HexabitzPlatform/H0FR7x-Hardware/README.md

# H0FR7x-Hardware
Hexabitz SPST 18V/20A MOSFET Switch Module Hardware Design
