HexabitzPlatform/H0FR7x-Hardware/Released/BOM/H0FR7.xlsx

 |  | www.hexabitz.com info@hexabitz.com |  | Bill Of Materials
Customer | Hexabitz | Revision | 3
Project | Hexabitz Modules | Date | 2024-06-17
Board | 20V/20A DC Switch / PWM Switch (H0FR7) | Notes
Designator | Description | Manufacturer Part Number | Manufacturer | Octopart Url | Quantity
X2 | 4 Position Wire to Board Terminal Block Horizontal with Board 0.200" (5.08mm) Through Hole | 1715747 | Phoenix Contact | https://octopart.com/1715747-phoenix+contact-35770?r=sp | 1
RESET | Headers & Wire Housings Unshrouded 1 POS T/H | 5-146280-1 | TE Connectivity | https://octopart.com/5-146280-1-te+connectivity+%2F+amp-40259676?r=sp | 1
SWD | Conn Unshrouded Header HDR 3 POS 2.54mm Solder ST Top Entry Thru-Hole Carton | 5-146281-3 | TE Connectivity | https://octopart.com/5-146281-3-te+connectivity+%2F+amp-39745942?r=sp | 1
R7 | Resistor Current Sense Metal Substrate 1206 2.5mOhm ±1% 1W ±50ppm/°C Paper T/R Automotive | PA1206FRE472U5Z | Yageo | https://octopart.com/pa1206fre472u5z-yageo-116359076?r=sp | 1
R2 | RES SMD 0.0OHM JUMPER 1/10W 0603 | RC0603JR-070RL | YAGEO [VR] | https://octopart.com/rc0603jr-070rl-yageo-1241539?r=sp | 1
R4 | RES 10 ohms 1/10w 1% 0603 | 0603WAF100JT5E | Royal Ohm | https://octopart.com/0603waf100jt5e-royal+ohm-127860301?r=sp | 1
R11 | SMD Chip Resistor, 47 Ohm, ± 1%, 100 mW, 0603 [1608 Metric], | RC0603FR-0747RL | Yageo | https://octopart.com/rc0603fr-0747rl-yageo-40952917?r=sp | 1
R5 | RES 150 OHM 1% 1/4W 0603 | CRGP0603F150R | TE Connectivity | https://octopart.com/1-2176326-5-te+connectivity-91016741?r=sp | 1
R1 | Thick Film Resistors - SMD 0603 270 Ohm 5% Tol | ERJ-3GEYJ271V | Panasonic | https://octopart.com/erj-3geyj271v-panasonic-55560546?r=sp | 1
R10, R13 | SMD Chip Resistor, 1 kOhm, ± 1%, 100 mW, 0603 [1608 Metric] | AC0603FR-131KL | Yageo | https://octopart.com/ac0603fr-131kl-yageo-73876229?r=sp | 2
R9 | 3.3 kOhms ±1% 0.1W, 1/10W Chip Resistor 0603 (1608 Metric) Moisture Resistant Thick Film | RC0603FR-073K3L | Yageo | https://octopart.com/rc0603fr-073k3l-yageo-40011875?r=sp | 1
R3 , R12 , R14 | RES 10K Ohm 1% 0603 | RC0603FR-0710KL | Yageo | https://octopart.com/rc0603fr-0710kl-yageo-40025538?r=sp | 3
R6, R8 | RES 49.9K OHM 1% 1/4W 0603 | ERJ-UP3F4992V | Panasonic Electronic Components | https://octopart.com/erj-up3f4992v-panasonic-108179032?r=sp | 2
R15 | RES 100K OHM 1% 1/10W 0603 | RC0603FR-10100KL | YAGEO | https://octopart.com/rc0603fr-10100kl-yageo-12819539?r=sp | 1
C14 | CAP 50V 1000pF 0603 X7R KEMET Multilayer Ceramic Capacitors MLCC-SMD/SMT | C0603C102J5RACTU | KEMET | https://octopart.com/c0603c102j5ractu-kemet-96704?r=sp | 1
C10, C11 | CAP CER 10000PF 50V X7R 0603 | CC0603KRX7R9BB103 | YAGEO | https://octopart.com/cc0603krx7r9bb103-yageo-192938?r=sp | 2
C1, C5, C7, C13 | CAP CER 0.1UF 25V X7R 0603 | CGA3E2X8R1E104K080AE | TDK | https://octopart.com/cga3e2x8r1e104k080ae-tdk-68305753?r=sp | 4
C8 ,C9 ,C12 | 0.1 µF ±10% 50V Ceramic Capacitor X7R 0603 (1608 Metric) | C1608X7R1H104K080AA | TDK | https://octopart.com/c1608x7r1h104k080aa-tdk-25947665?r=sp | 3
C2 | CAP CER 1 UF 16V X7R 0805 | CC0805KKX7R7BB105 | YAGEO [VA] | https://octopart.com/cc0805kkx7r7bb105-yageo-8376555?r=sp | 1
C6 | CAP CER 4.7UF 16V X7R 0805 | C0805C475K4RACTU | KEMET [VA] | https://octopart.com/c0805c475k4ractu-kemet-22859922?r=sp | 1
C15 | Aluminium Electrolytic Capacitors - Radial Leaded 35V 470uF 105C 2k Hour Radial | ESH477M035AH3AA | KEMET | https://octopart.com/esh477m035ah3aa-kemet-22264614?r=sp | 1
FB1 | Ind chip Bead Multi-Layer 30 ohms 25% 100MHZ Ferrite 1,5A 0603Punched paper T/R | MMZ1608Y300BTA00 | TDK | https://octopart.com/mmz1608y300bta00-tdk-7906990?r=sp | 1
D1 | Red 0603 130° Clear 54 mcd 2 V Surface Mount ChipLED | VLMS1300-GS08 | Vishay | https://octopart.com/vlms1300-gs08-vishay-21709201?r=sp&s=0nXJNjGsSbWwqfqWlZv0EA | 1
D2 | TVS DIODE 3,3V 10,9V SOD323 | CDSOD323-T03SC | BOURNS INC | https://octopart.com/cdsod323-t03sc-bourns-10487153?r=sp | 1
D3 ,D4 | Small Signal Diode, Single, 100 V, 300 Ma, 1.25 V, 4 Ns, 2 A Rohs | 1N4148W-7-F | Diodes Inc | https://octopart.com/1n4148w-7-f-diodes+inc.-55386411?r=sp | 2
D5 | Zener Diode 1.8 V 500 mW ±5% Surface Mount SOD-123 | MMSZ4678T1G | onsemi | https://octopart.com/mmsz4678t1g-onsemi-29993?r=sp | 1
D6 | Rectifier Diode, Schottky, 1 Phase, 1 Element, 2.8A, 100V | V8PAM10S-M3/H | Vishay | https://octopart.com/v8pam10s-m3%2Fh-vishay-109273831?r=sp | 1
Q2 | P-channel 40 V, 0.0175 Ω typ.,36 A, STripFET™ F6 Power MOSFET in a DPAK package | STD36P4LLF6 | STMicroelectronics | https://octopart.com/std36p4llf6-stmicroelectronics-34425371?r=sp | 1
Q1 | Transistor, Bipolar, Si, NPN, General Purpose, VCEO 40VDC, IC 200mA, PD 225mW, SOT-23 | MMBT3904LT1G | ON Semiconductor | https://octopart.com/mmbt3904lt1g-on+semiconductor-3280?r=sp | 1
U1 | MCU 32-bit ARM Cortex M0+ RISC 512KB Flash 1.8V/2.5V/3.3V 48-Pin UFQFPN EP Tray | STM32G0B1CEU6 | STMicroelectronics | https://octopart.com/stm32g0b1ceu6-stmicroelectronics-116363364?r=sp | 1
U2 | High bandwidth (20MH / Operational Amplifiers - Op Amps | TSV772IYDT | STMicroelectronics | https://octopart.com/tsv772iydt-stmicroelectronics-126487015?r=sp | 1
U3 | 40 V 1 A NPN/PNP Transistor Pair PushPull MOSFET Driver | PMD3001D,115 | Nexperia | https://octopart.com/pmd3001d%2C115-nexperia-78741352?r=sp | 1
X1 | 8,0000MHZ 33pF SMD MURATA Resonators | CSTNE8M00G550000R0 | Murata | https://octopart.com/cstne8m00g550000r0-murata-91406934?r=sp | 1
