HexabitzPlatform/H0FR7x-Hardware/Documentation/H0FR7 Schematics.pdf

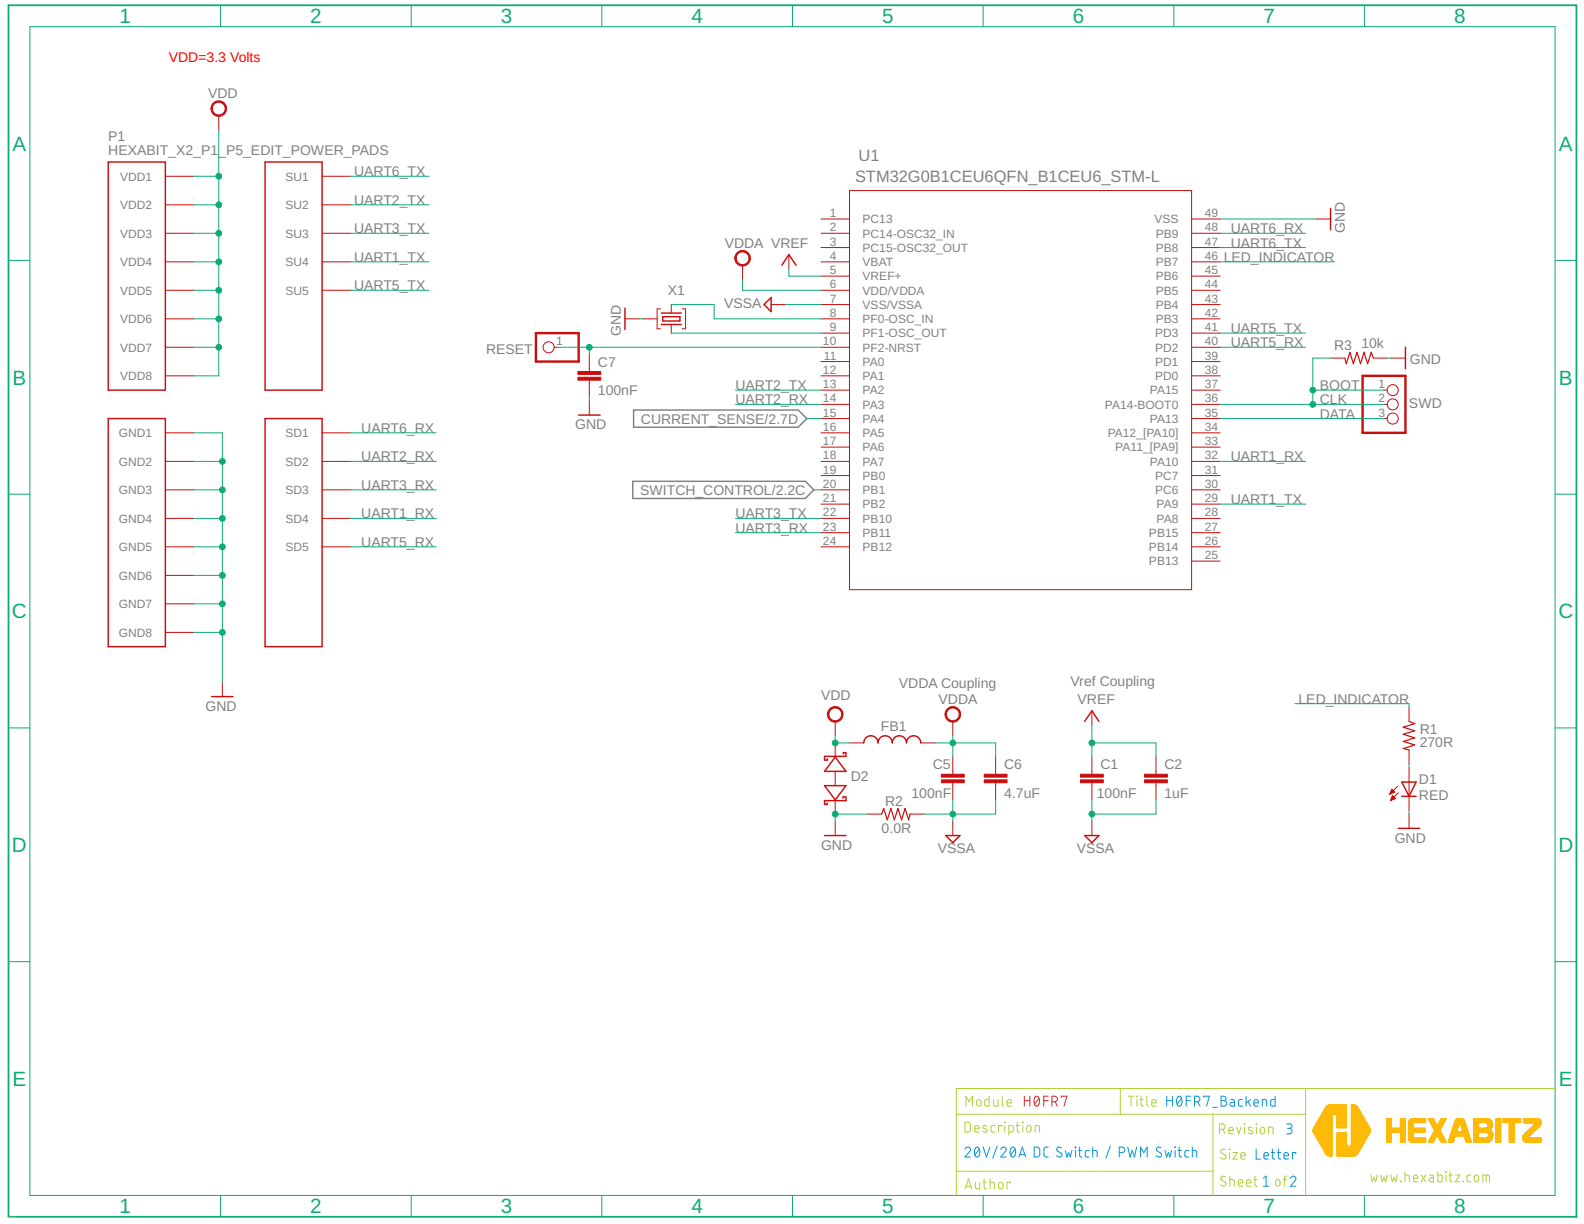
[picture p1: page 1]

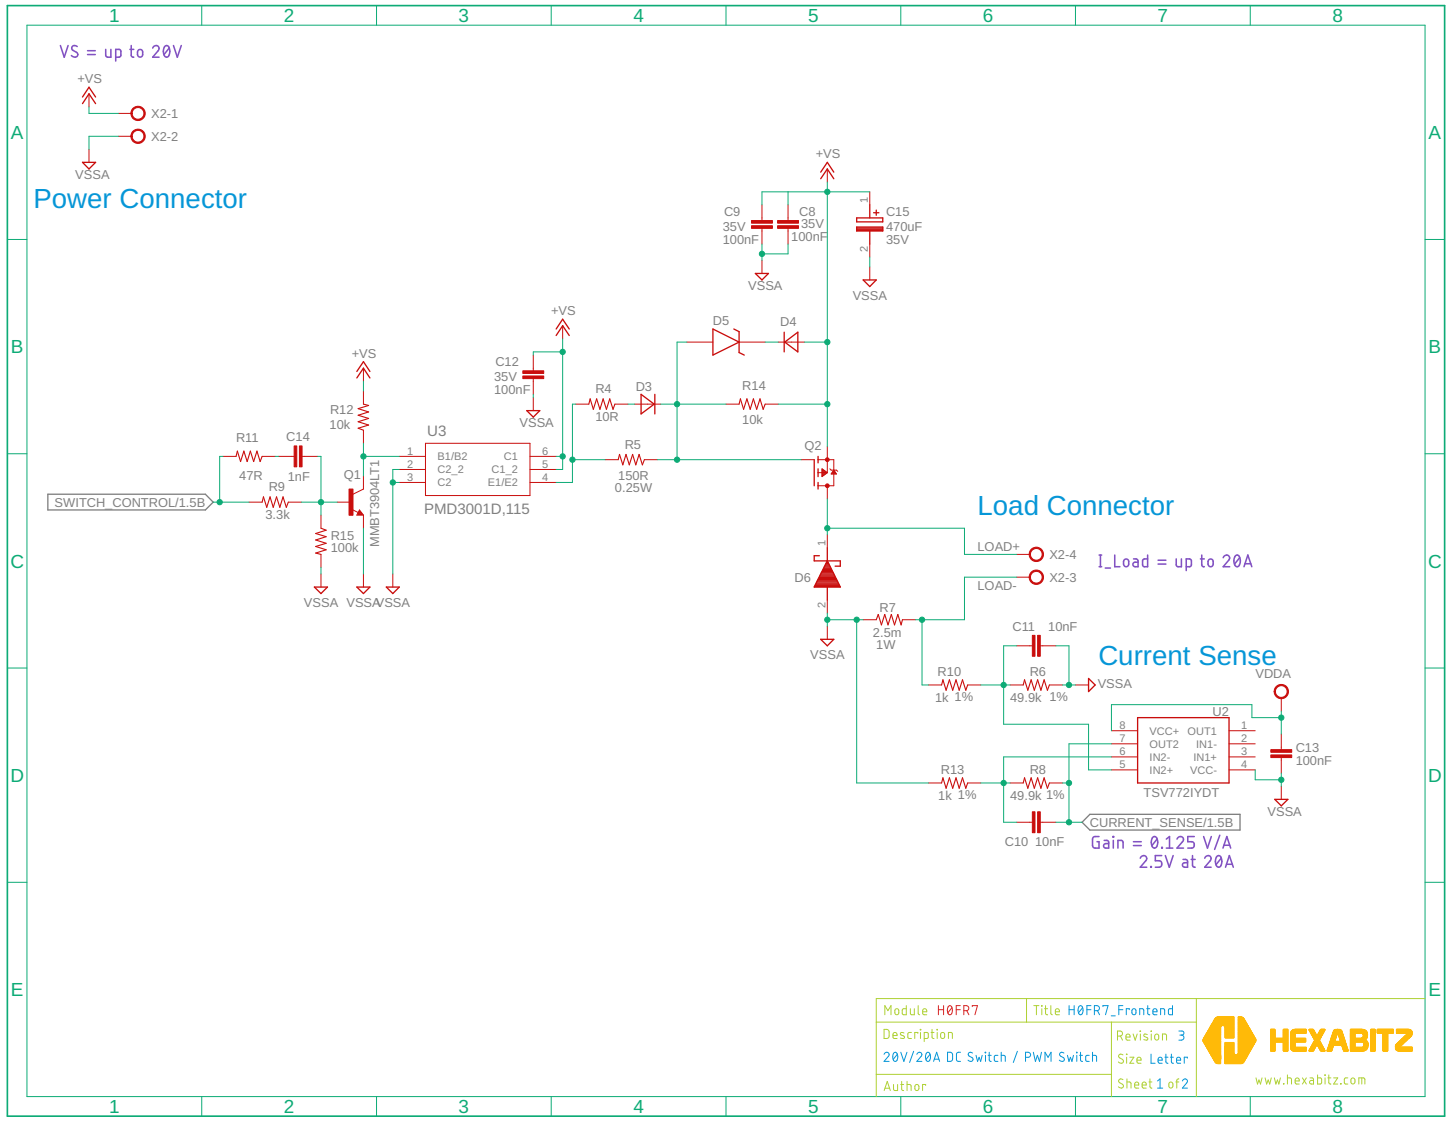
[picture p2: page 2]
