HexabitzPlatform/H0FR7x-Hardware/Design/H0FR7.brd

## EAGLE design Design/H0FR7.brd (2024-07-15)

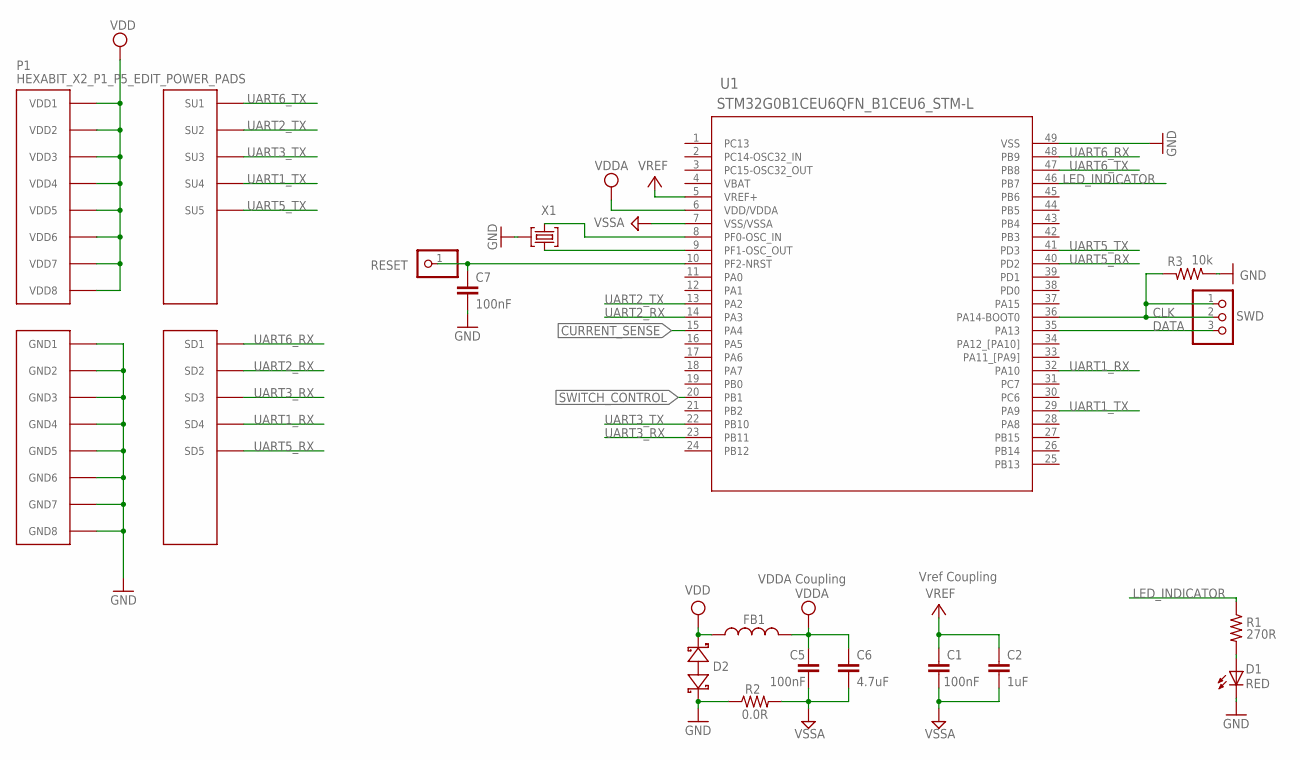
[picture p3: schematic H0FR7.sch, sheet 1]

Parts:
C1, C7: 100nF; C-0603; TOLERANCE 10%; VOLTAGE_RATING 10V; MPN C0603C104K8RACTU
C2: 1uF; C-0805
C5: 100nF; C-0603
C6: 4.7uF; C-0805
D1: RED; VLMS1300-GS08; MPN VLMS1300-GS08
D2: BOURNS_CDSOD323-T03SCBOURNS_CDSOD323-T03SC_0_0; BOURNS_CDSOD323-T03SC_0
FB1: FB-0603
P1: HEXABIT_X2_P1_P5_EDIT_POWER_PADS
R1: 270R; R-0603
R2: 0.0R; R-0603
R3: 10k; R-0603; TOLERANCE 5%; MPN RC0603JR-0710KL
RESET: R; 1X01
SWD: PINHD-1X3SWD; SWD
TRIMBLE-LOGO2: HEXA-LOGO
U1: STM32G0B1CEU6QFN_B1CEU6_STM-L; QFN_B1CEU6_STM-L
X1: XTALL_CSTCE8M00G52

Connections:
CLK: R3.2, SWD.1, SWD.2, U1.36 (PA14-BOOT0)
CURRENT_SENSE: U1.15 (PA4); also elsewhere on the board
DATA: SWD.3, U1.35 (PA13)
GND: C7.2, D1.C, D2.2 (C), P1.PAD_PD11 (GND1), P1.PAD_PD12 (GND2), P1.PAD_PD13 (GND3), P1.PAD_PD14 (GND4), P1.PAD_PD17 (GND5), P1.PAD_PD18 (GND6), P1.PAD_PD19 (GND7), P1.PAD_PD20 (GND8), R2.1, R3.1, U1.49 (VSS), X1.P$2 (2)
LED_INDICATOR: R1.1, U1.46 (PB7)
unnamed: U1.9 (PF1-OSC_OUT), X1.P$3 (3)
unnamed: U1.8 (PF0-OSC_IN), X1.P$1 (1)
unnamed: D1.A, R1.2
unnamed: C7.1, RESET.1, U1.10 (PF2-NRST)
SWITCH_CONTROL: U1.20 (PB1); also elsewhere on the board
UART1_RX: P1.PAD_PD4 (SD4), U1.32 (PA10)
UART1_TX: P1.PAD_PU4 (SU4), U1.29 (PA9)
UART2_RX: P1.PAD_PD2 (SD2), U1.14 (PA3)
UART2_TX: P1.PAD_PU2 (SU2), U1.13 (PA2)
UART3_RX: P1.PAD_PD3 (SD3), U1.23 (PB11)
UART3_TX: P1.PAD_PU3 (SU3), U1.22 (PB10)
UART5_RX: P1.PAD_PD5 (SD5), U1.40 (PD2)
UART5_TX: P1.PAD_PU5 (SU5), U1.41 (PD3)
UART6_RX: P1.PAD_PD1 (SD1), U1.48 (PB9)
UART6_TX: P1.PAD_PU1 (SU1), U1.47 (PB8)
VDD: D2.1 (A), FB1.1, P1.PAD_PU11 (VDD1), P1.PAD_PU12 (VDD2), P1.PAD_PU13 (VDD3), P1.PAD_PU14 (VDD4), P1.PAD_PU17 (VDD5), P1.PAD_PU18 (VDD6), P1.PAD_PU19 (VDD7), P1.PAD_PU20 (VDD8)
VDDA: C5.1, C6.1, FB1.2, U1.6 (VDD/VDDA); also elsewhere on the board
VREF: C1.1, C2.1, U1.5 (VREF+)
VSSA: C1.2, C2.2, C5.2, C6.2, R2.2, U1.7 (VSS/VSSA); also elsewhere on the board

Notes on the sheet:
Vref Coupling
VDDA Coupling

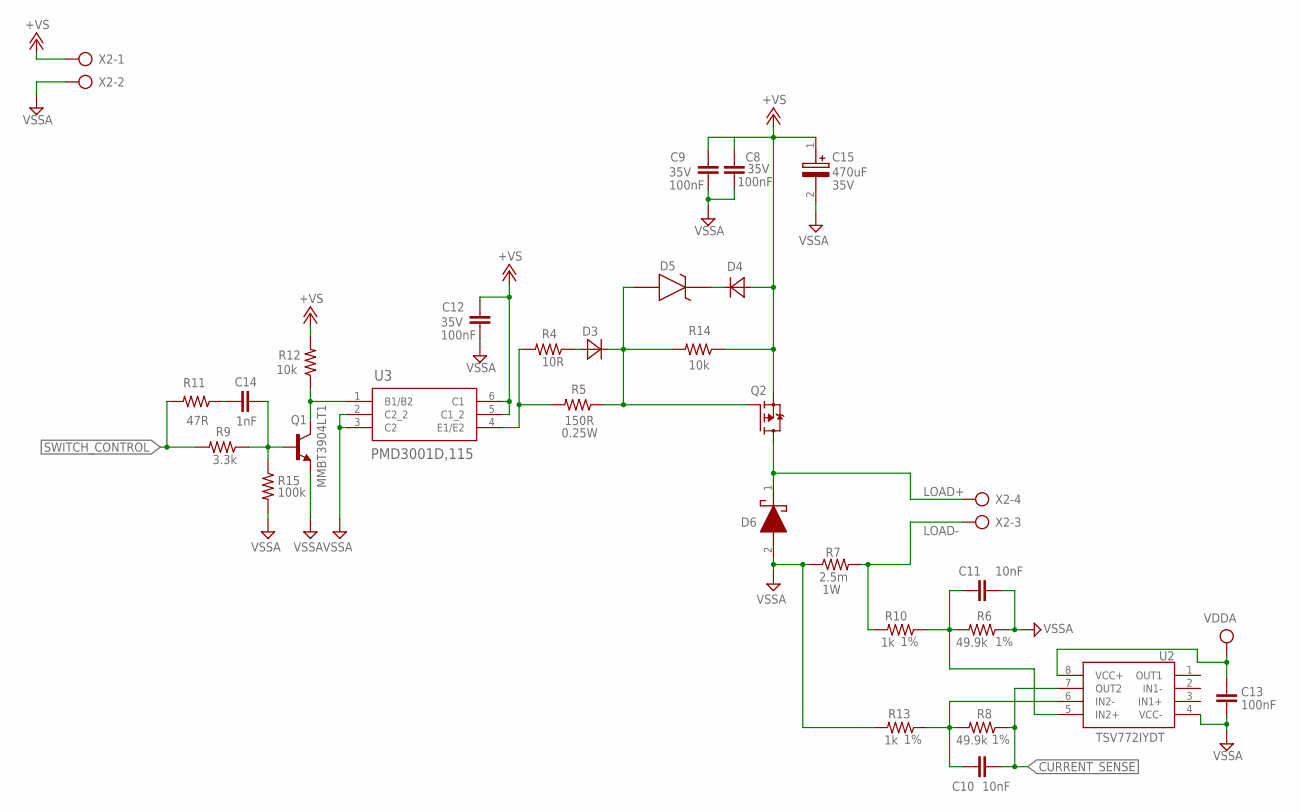
[picture p4: schematic H0FR7.sch, sheet 2]

Parts:
C8, C9, C12: C-0603; VOLTAGE_RATING 35V
C10, C11: 10nF; C-0603; TOLERANCE 10V; VOLTAGE_RATING 10%; MPN C0603C104K8RACTU
C13: 100nF; C-0603; TOLERANCE 10V; VOLTAGE_RATING 10%; MPN C0603C104K8RACTU
C14: 1nF; C-0603; TOLERANCE 10%; VOLTAGE_RATING 10V; MPN C0603C104K8RACTU
C15: ESH477M035AH3AA; CAPPRD500W60D1000H1700
D3, D4: DIOD-SOD-123; SOD123; MPN 1N4148W-7-F
D5: MMSZ4705T1GMMSZ4705T1G; DIO_MMSZ4700T1G; VOLTAGE 18V; MPN MMSZ4678T1G
D6: V8PAM10S-M3_H; V8PAM10SHM3H
Q1: MMBT3904LT1
Q2: STD36P4LLF6; DPAK-3
R4: 10R; R-0603; TOLERANCE 5%; MPN RC0603JR-07680KL
R5: 150R; R-0603; MPN CRGP0603F150R
R6, R8: 49.9k; R-0603; TOLERANCE 1%; MPN RC0603JR-071KL
R7: 2.5m; R1206; MPN PA1206FRE472U5Z
R9: 3.3k; R-0603; TOLERANCE 5%; MPN RC0603JR-07680KL
R10, R13: 1k; R-0603; TOLERANCE 1%; MPN RC0603JR-071KL
R11: 47R; R-0603; TOLERANCE 5%; MPN RC0603JR-07680KL
R12: 10k; R-0603; TOLERANCE 5%; MPN RC0603JR-0710KL
R14: 10k; R-0603; TOLERANCE 5%; MPN RC0603JR-07680KL
R15: 100k; R-0603; TOLERANCE 5%; MPN RC0603JR-07680KL
U2: TSV772IYDT; SOIC127P600X175-8N
U3: PMD3001D,115; SOT457_NEX
X2: AK300/4

Connections:
+VS: C8.2, C9.2, C12.2, C15.1 (+), D4.1 (A), Q2.3 (S), R12.2, R14.1, U3.5 (C1_2), U3.6 (C1), X2.1
CURRENT_SENSE: C10.2, R8.1, U2.7 (OUT2); also elsewhere on the board
LOAD+: D6.1 (K), Q2.4 (D), X2.4
LOAD-: R7.2, R10.2, X2.3
unnamed: Q1.3 (C), R12.1, U3.1 (B1/B2)
unnamed: C11.1, R6.2, R10.1, U2.5 (IN2+)
unnamed: D4.2 (C), D5.K
unnamed: C10.1, R8.2, R13.1, U2.6 (IN2-)
unnamed: D3.1 (A), R4.1
unnamed: C14.2, Q1.1 (B), R9.1, R15.1
unnamed: C14.1, R11.1
unnamed: R4.2, R5.2, U3.4 (E1/E2)
unnamed: D3.2 (C), D5.A, Q2.1 (G), R5.1, R14.2
SWITCH_CONTROL: R9.2, R11.2; also elsewhere on the board
VDDA: C13.2, U2.8 (VCC+); also elsewhere on the board
VSSA: C8.1, C9.1, C11.2, C12.1, C13.1, C15.2 (-), D6.2 (A), Q1.2 (E), R6.1, R7.1, R13.2, R15.2, U2.4 (VCC-), U3.2 (C2_2), U3.3 (C2), X2.2; also elsewhere on the board

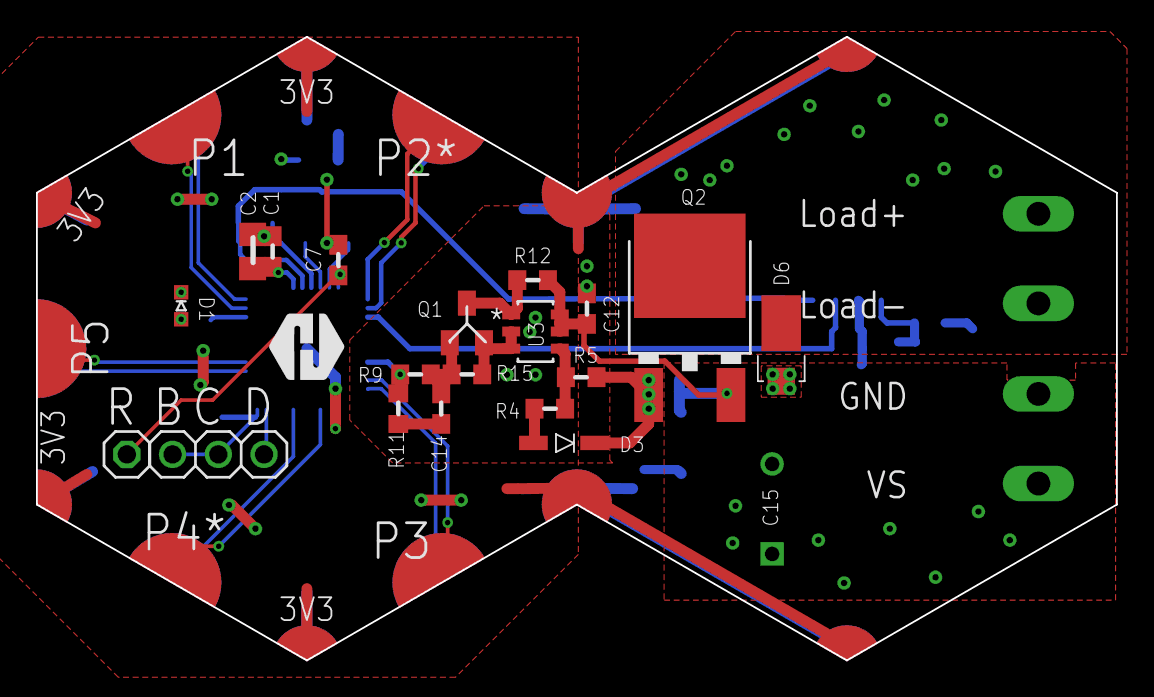
[picture p5: board H0FR7.brd from above]

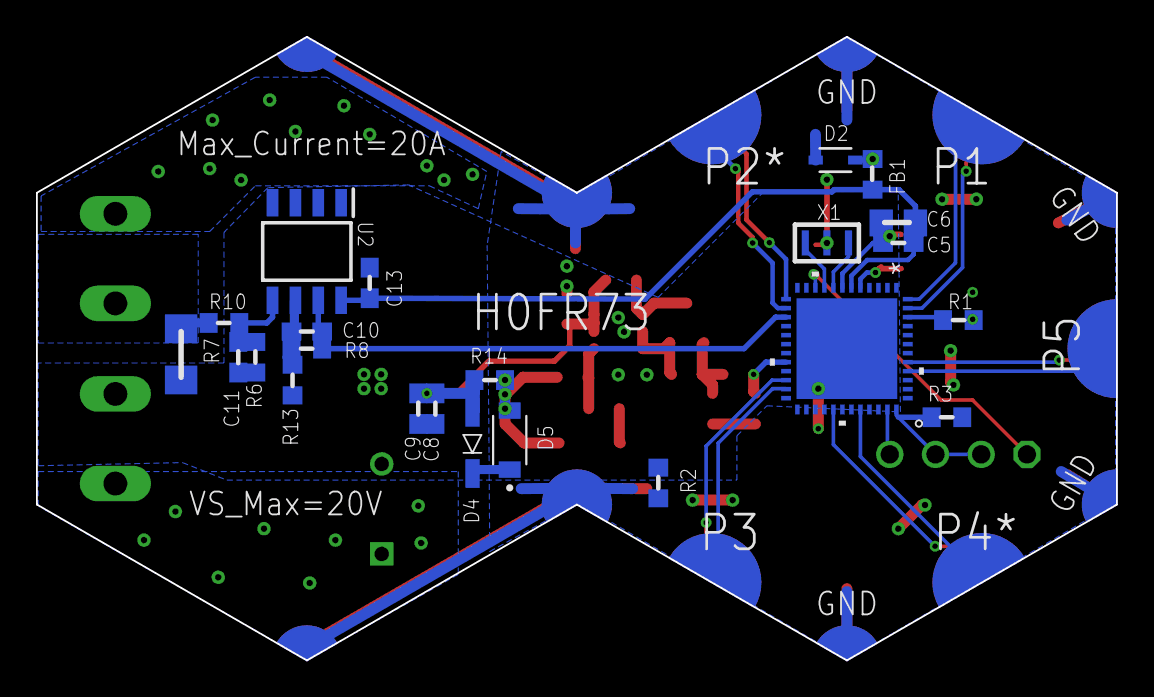
[picture p6: board H0FR7.brd from below]

Board: 2 copper layers, 60.0 x 34.6 mm, 46 parts (23 on the bottom side), 36 nets.
