HexabitzPlatform/H0FR7x-Hardware/H0FR70/Design/H0FR70.sch

## EAGLE design H0FR70/Design/H0FR70.sch (2020-05-23)

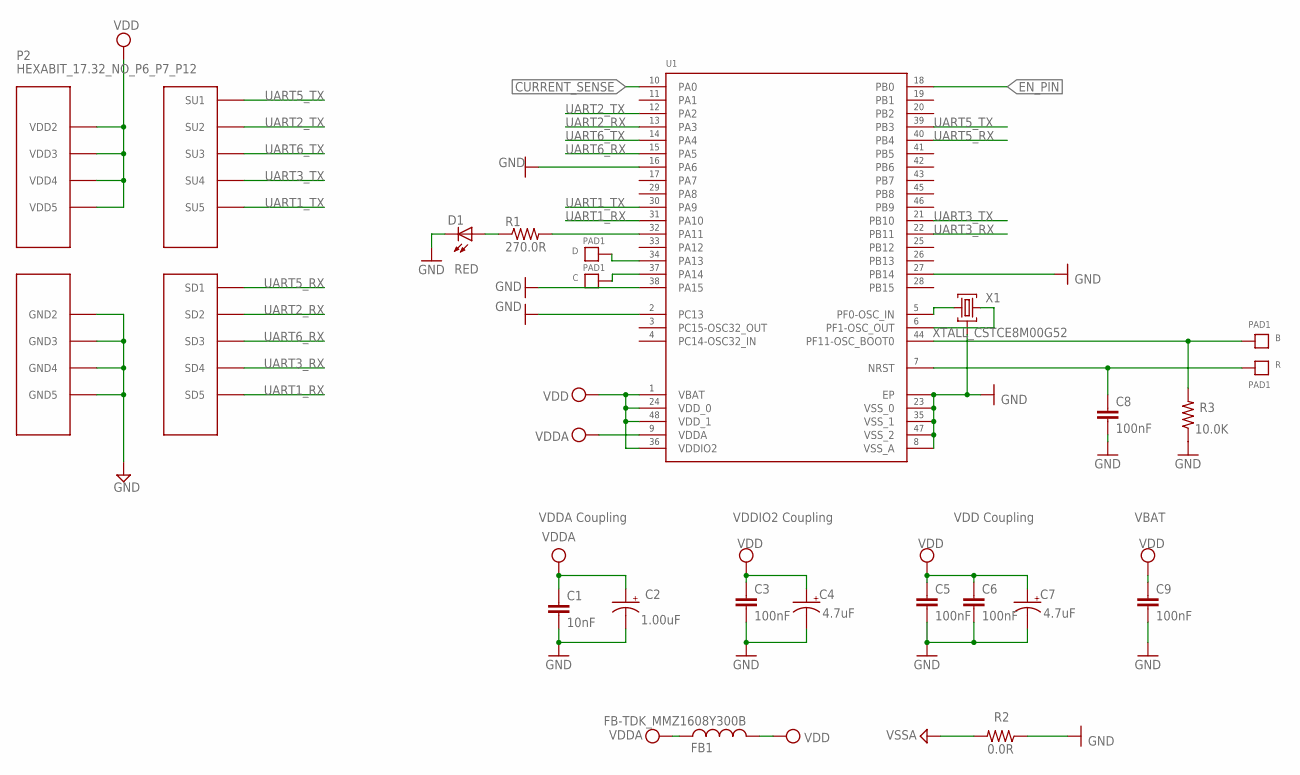
[picture p7: schematic H0FR70.sch, sheet 1]

Parts:
B: PAD1
C: PAD1
C1: 10nF; C-0603; TOLERANCE 10%; VOLTAGE_RATING 50V; MPN C0603C103K5RACTU
C2: 1.00uF; C-0805-POL; TOLERANCE 10%; VOLTAGE_RATING 16V; MPN CC0805KKX7R7BB105
C3, C6, C8: 100nF; C-0603; TOLERANCE 10%; VOLTAGE_RATING 10V; MPN C0603C104K8RACTU
C4, C7: 4.7uF; C-0805-POL; TOLERANCE 10%; VOLTAGE_RATING 25V; MPN GRM21BC81E475KA12L
C5: 100nF; C-0603; TOLERANCE 10%; VOLTAGE_RATING 10; MPN C0603C104K8RACTU
C9: 100nF; C-0603; TOLERANCE 10V; VOLTAGE_RATING 10%; MPN C0603C104K8RACTU
D: PAD1
D1: RED; VLMS1300-GS08; MPN VLMS1300-GS08
FB1: FB-TDK_MMZ1608Y300B; MPN MMZ1608Y300B
P2: HEXABIT_17.32_NO_P6_P7_P12
R: PAD1
R1: 270.0R; R-0603; TOLERANCE 1%; MPN RC0603FR-07270RL
R2: 0.0R; R-0603; MPN RC0603JR-070RL
R3: 10.0K; R-0603; TOLERANCE 5%; MPN RC0603JR-0710KL
U1: STM32F091CBU6
X1: XTALL_CSTCE8M00G52

Connections:
AGND: R2.2
B1: B.P$1, R3.2, U1.P$44 (PF11-OSC_BOOT0)
CURRENT_SENSE: U1.P$10 (PA0)
EN_PIN: U1.P$18 (PB0)
GND: C1.2, C2.2 (-), C3.2, C4.2 (-), C5.2, C6.2, C7.2 (-), C8.2, C9.2, D1.C, P2.PAD_PD8 (GND2), P2.PAD_PD9 (GND3), P2.PAD_PD10 (GND4), P2.PAD_PD11 (GND5), R2.1, R3.1, U1.EP, U1.P$2 (PC13), U1.P$8 (VSS_A), U1.P$16 (PA6), U1.P$23 (VSS_0), U1.P$27 (PB14), U1.P$35 (VSS_1), U1.P$38 (PA15), U1.P$47 (VSS_2), X1.P$2 (2)
unnamed: D.P$1, U1.P$34 (PA13)
unnamed: C.P$1, U1.P$37 (PA14)
unnamed: R1.2, U1.P$32 (PA11)
unnamed: D1.A, R1.1
unnamed: U1.P$5 (PF0-OSC_IN), X1.P$1 (1)
unnamed: U1.P$6 (PF1-OSC_OUT), X1.P$3 (3)
R1: C8.1, R.P$1, U1.P$7 (NRST)
UART1_RX: P2.PAD_PD5 (SD5), U1.P$31 (PA10)
UART1_TX: P2.PAD_PU5 (SU5), U1.P$30 (PA9)
UART2_RX: P2.PAD_PD2 (SD2), U1.P$13 (PA3)
UART2_TX: P2.PAD_PU2 (SU2), U1.P$12 (PA2)
UART3_RX: P2.PAD_PD4 (SD4), U1.P$22 (PB11)
UART3_TX: P2.PAD_PU4 (SU4), U1.P$21 (PB10)
UART5_RX: P2.PAD_PD1 (SD1), U1.P$40 (PB4)
UART5_TX: P2.PAD_PU1 (SU1), U1.P$39 (PB3)
UART6_RX: P2.PAD_PD3 (SD3), U1.P$15 (PA5)
UART6_TX: P2.PAD_PU3 (SU3), U1.P$14 (PA4)
VDD: C3.1, C4.1 (+), C5.1, C6.1, C7.1 (+), C9.1, FB1.2, P2.PAD_PU8 (VDD2), P2.PAD_PU9 (VDD3), P2.PAD_PU10 (VDD4), P2.PAD_PU11 (VDD5), U1.P$1 (VBAT), U1.P$24 (VDD_0), U1.P$36 (VDDIO2), U1.P$48 (VDD_1)
VDDA: C1.1, C2.1 (+), FB1.1, U1.P$9 (VDDA)

Notes on the sheet:
VDDA Coupling
VDDIO2 Coupling
VDD Coupling
VBAT

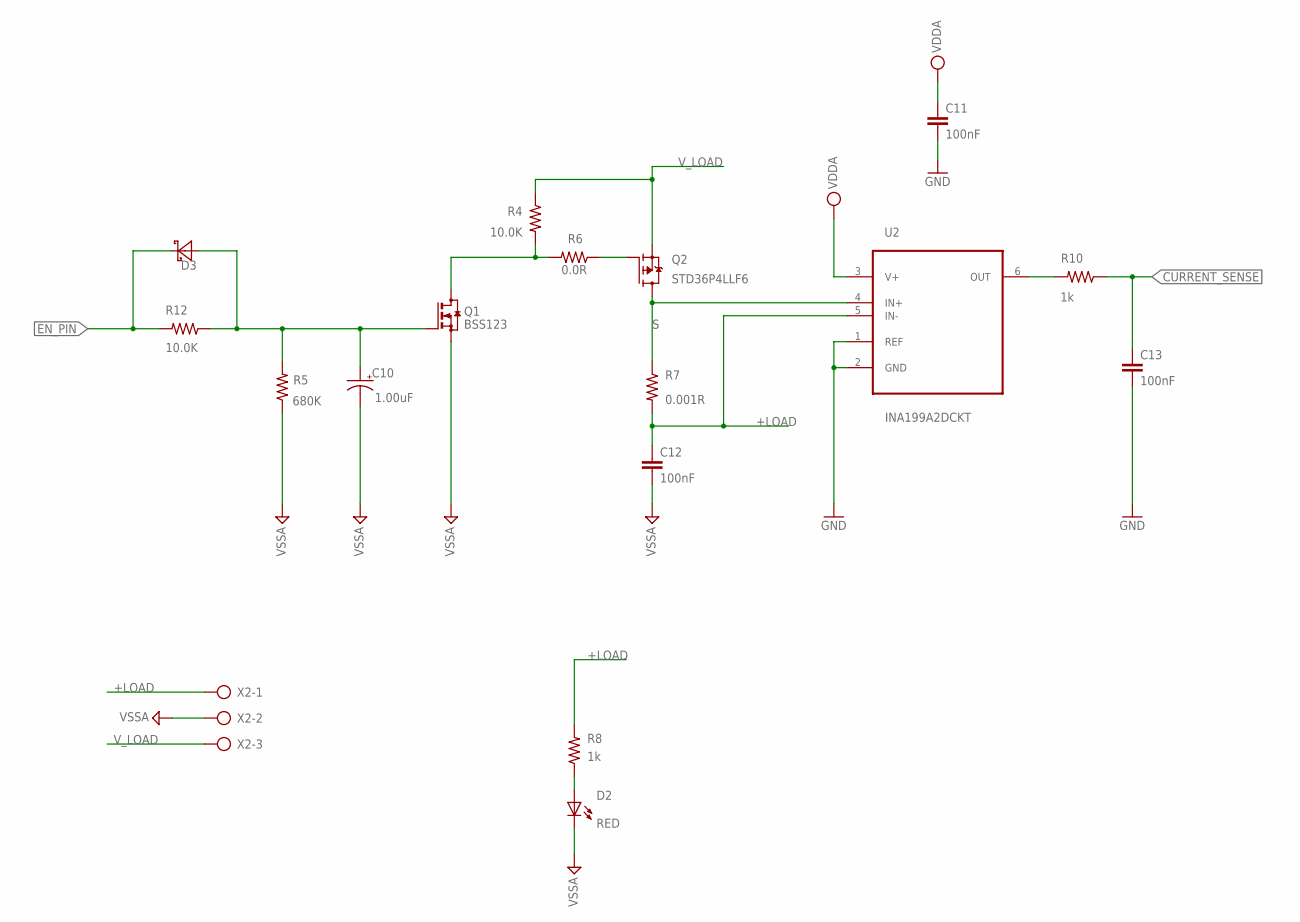
[picture p8: schematic H0FR70.sch, sheet 2]

Parts:
C10: 1.00uF; C-0805-POL; TOLERANCE 10%; VOLTAGE_RATING 16V; MPN CC0805KKX7R7BB105
C11: 100nF; C-0603; TOLERANCE 10V; VOLTAGE_RATING 10%; MPN C0603C104K8RACTU
C12, C13: 100nF; C-0603; TOLERANCE 10%; VOLTAGE_RATING 10V; MPN C0603C104K8RACTU
D2: RED; VLMS1300-GS08; MPN VLMO1300-GS08
D3: SMD-DIODE-SCHOTTKY-40V-300MA(SOD-323); SOD-323
Q1: BSS123; SOT23
Q2: STD36P4LLF6; DPAK-3
R4, R12: 10.0K; R-0603; TOLERANCE 5%; MPN RC0603JR-0710KL
R5: 680K; R-0603; TOLERANCE 5%; MPN RC0603JR-07680KL
R6: 0.0R; R-0603; MPN RC0603JR-070RL
R7: 0.001R; R2512
R8: 1k; R-0603; TOLERANCE 1%; MPN RC0603JR-071KL
R10: 1k; R-0603; TOLERANCE 5%; MPN RC0603JR-071KL
U2: INA199A2DCKT; SOT65P210X110-6N
X2: AK500/3

Connections:
+LOAD: C12.1, R7.2, R8.2, U2.5 (IN-), X2.1
AGND: C10.2 (-), C12.2, D2.C, Q1.2 (S), R5.1, X2.2
CURRENT_SENSE: C13.1, R10.1
EN_PIN: D3.- (C), R12.2
GND: C11.2, C13.2, U2.1 (REF), U2.2 (GND)
unnamed: Q1.3 (D), R4.2, R6.2
unnamed: D2.A, R8.1
unnamed: R10.2, U2.6 (OUT)
unnamed: Q2.1 (G), R6.1
unnamed: C10.1 (+), D3.+ (A), Q1.1 (G), R5.2, R12.1
S: Q2.4 (D), R7.1, U2.4 (IN+)
VDDA: C11.1, U2.3 (V+)
V_LOAD: Q2.3 (S), R4.1, X2.3
