HexabitzPlatform/H0FR7x-Hardware/H0FR71/Design/H0FR71.sch

## EAGLE design H0FR71/Design/H0FR71.sch (2022-08-15)

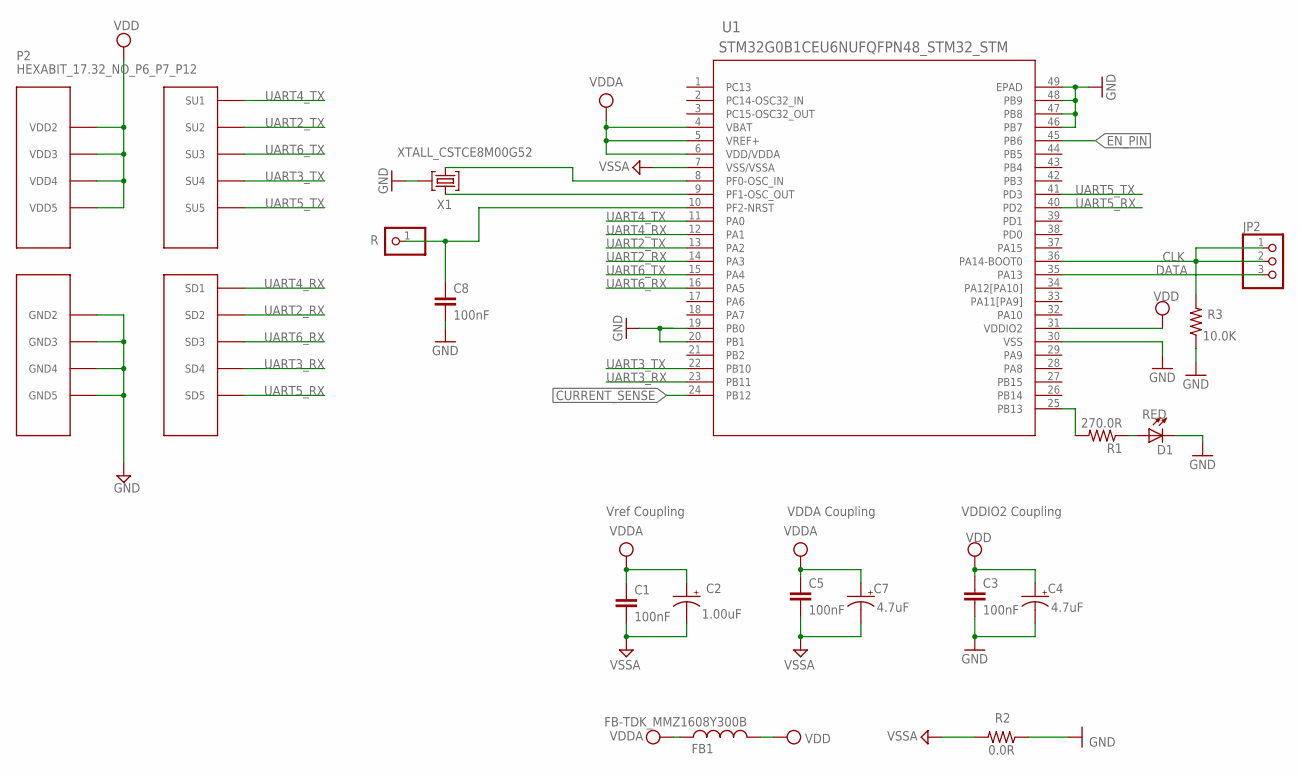
[picture p9: schematic H0FR71.sch, sheet 1]

Parts:
C1, C3, C8: 100nF; C-0603; TOLERANCE 10%; VOLTAGE_RATING 10V; MPN C0603C104K8RACTU
C2: 1.00uF; C-0805-POL; TOLERANCE 10%; VOLTAGE_RATING 16V; MPN CC0805KKX7R7BB105
C4, C7: 4.7uF; C-0805-POL; TOLERANCE 10%; VOLTAGE_RATING 25V; MPN GRM21BC81E475KA12L
C5: 100nF; C-0603; TOLERANCE 10%; VOLTAGE_RATING 10; MPN C0603C104K8RACTU
D1: RED; VLMS1300-GS08; MPN VLMS1300-GS08
FB1: FB-TDK_MMZ1608Y300B; MPN MMZ1608Y300B
JP2: PINHD-1X3; 1X03
P2: HEXABIT_17.32_NO_P6_P7_P12
R: PINHD-1X1; 1X01
R1: 270.0R; R-0603; TOLERANCE 1%; MPN RC0603FR-07270RL
R2: 0.0R; R-0603; MPN RC0603JR-070RL
R3: 10.0K; R-0603; TOLERANCE 5%; MPN RC0603JR-0710KL
U1: STM32G0B1CEU6NUFQFPN48_STM32_STM; UFQFPN48_STM32_STM
X1: XTALL_CSTCE8M00G52

Connections:
AGND: C1.2, C2.2 (-), C5.2, C7.2 (-), R2.2, U1.7 (VSS/VSSA)
CLK: JP2.1, JP2.2, R3.2, U1.36 (PA14-BOOT0)
CURRENT_SENSE: U1.24 (PB12)
DATA: JP2.3, U1.35 (PA13)
EN_PIN: U1.45 (PB6)
GND: C3.2, C4.2 (-), C8.2, D1.C, P2.PAD_PD8 (GND2), P2.PAD_PD9 (GND3), P2.PAD_PD10 (GND4), P2.PAD_PD11 (GND5), R2.1, R3.1, U1.19 (PB0), U1.20 (PB1), U1.30 (VSS), U1.46 (PB7), U1.47 (PB8), U1.48 (PB9), U1.49 (EPAD), X1.P$2 (2)
unnamed: U1.9 (PF1-OSC_OUT), X1.P$3 (3)
unnamed: U1.8 (PF0-OSC_IN), X1.P$1 (1)
unnamed: R1.2, U1.25 (PB13)
unnamed: D1.A, R1.1
unnamed: C8.1, R.1, U1.10 (PF2-NRST)
UART2_RX: P2.PAD_PD2 (SD2), U1.14 (PA3)
UART2_TX: P2.PAD_PU2 (SU2), U1.13 (PA2)
UART3_RX: P2.PAD_PD4 (SD4), U1.23 (PB11)
UART3_TX: P2.PAD_PU4 (SU4), U1.22 (PB10)
UART4_RX: P2.PAD_PD1 (SD1), U1.12 (PA1)
UART4_TX: P2.PAD_PU1 (SU1), U1.11 (PA0)
UART5_RX: P2.PAD_PD5 (SD5), U1.40 (PD2)
UART5_TX: P2.PAD_PU5 (SU5), U1.41 (PD3)
UART6_RX: P2.PAD_PD3 (SD3), U1.16 (PA5)
UART6_TX: P2.PAD_PU3 (SU3), U1.15 (PA4)
VDD: C3.1, C4.1 (+), FB1.2, P2.PAD_PU8 (VDD2), P2.PAD_PU9 (VDD3), P2.PAD_PU10 (VDD4), P2.PAD_PU11 (VDD5), U1.31 (VDDIO2)
VDDA: C1.1, C2.1 (+), C5.1, C7.1 (+), FB1.1, U1.4 (VBAT), U1.5 (VREF+), U1.6 (VDD/VDDA)

Notes on the sheet:
VDDA Coupling
VDDIO2 Coupling
Vref Coupling

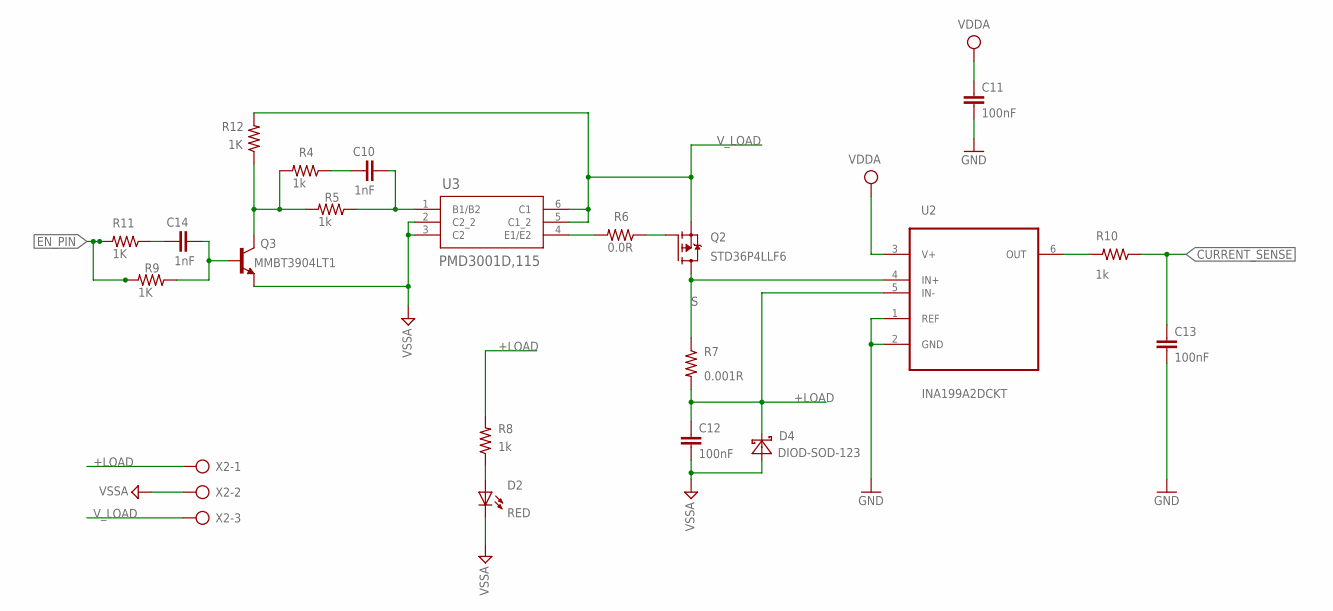
[picture p10: schematic H0FR71.sch, sheet 2]

Parts:
C10, C14: 1nF; C-0603; TOLERANCE 10%; VOLTAGE_RATING 10V; MPN C0603C104K8RACTU
C11: 100nF; C-0603; TOLERANCE 10V; VOLTAGE_RATING 10%; MPN C0603C104K8RACTU
C12, C13: 100nF; C-0603; TOLERANCE 10%; VOLTAGE_RATING 10V; MPN C0603C104K8RACTU
D2: RED; VLMS1300-GS08; MPN VLMO1300-GS08
D4: DIOD-SOD-123; SOD123
Q2: STD36P4LLF6; DPAK-3
Q3: MMBT3904LT1
R4, R5: 1k; R-0603; TOLERANCE 5%; MPN RC0603JR-07680KL
R6: 0.0R; R-0603; MPN RC0603JR-070RL
R7: 0.001R; R2512
R8: 1k; R-0603; TOLERANCE 1%; MPN RC0603JR-071KL
R9, R11: 1K; R-0603; TOLERANCE 5%; MPN RC0603JR-07680KL
R10: 1k; R-0603; TOLERANCE 5%; MPN RC0603JR-071KL
R12: 1K; R-0603; TOLERANCE 5%; MPN RC0603JR-0710KL
U2: INA199A2DCKT; SOT65P210X110-6N
U3: PMD3001D,115; SOT457_NEX
X2: AK500/3

Connections:
+LOAD: C12.1, D4.2 (C), R7.2, R8.2, U2.5 (IN-), X2.1
AGND: C12.2, D2.C, D4.1 (A), Q3.2 (E), U3.2 (C2_2), U3.3 (C2), X2.2
CURRENT_SENSE: C13.1, R10.1
EN_PIN: R9.2, R11.2
GND: C11.2, C13.2, U2.1 (REF), U2.2 (GND)
unnamed: C10.2, R5.1, U3.1 (B1/B2)
unnamed: D2.A, R8.1
unnamed: R10.2, U2.6 (OUT)
unnamed: Q2.1 (G), R6.1
unnamed: Q3.3 (C), R4.2, R5.2, R12.1
unnamed: R6.2, U3.4 (E1/E2)
unnamed: C10.1, R4.1
unnamed: C14.2, Q3.1 (B), R9.1
unnamed: C14.1, R11.1
S: Q2.4 (D), R7.1, U2.4 (IN+)
VDDA: C11.1, U2.3 (V+)
V_LOAD: Q2.3 (S), R12.2, U3.5 (C1_2), U3.6 (C1), X2.3
