HexabitzPlatform/H0FR7x-Hardware/(commit log)

2020-04-06 final_unchecked power traces NOT soldered info. NOT written
    [H0FR70.brd, H0FR70.sch]
2020-04-09 current sense pin connnected to PA0 (ADC_IN0) Orange indicator led in parallel with load remove power pads at top adding lables & notes
    [H0FR70.brd, H0FR70.sch]
2020-04-10 fix a bug in schematics
    [H0FR70.brd, H0FR70.sch]
2020-04-19 changing power connector to PTR500 (AK500/3) adding voltage diveder at the gate of power transistor (4.7/14.7)
    [H0FR70.brd, H0FR70.sch]
2020-04-21 adding: zenar at gate + 0R res
    [H0FR70.brd, H0FR70.sch]
2020-04-27 OUTPUT files were added
    [H0FR70.sch, H0FR70.xlsx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]
2020-05-19 Zener was deleted prooerties was changed to 12V 20A
    [H0FR70.brd, H0FR70.sch, H0FR70.xlsx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]
2020-05-23 PDF fixed R8 changed (2k2 -> 1k) BOM modified
    [H0FR70.brd, H0FR70.sch, H0FR70.xlsx]
2022-08-15 - Changing the MC with STM32G0 - Editing the frontend design so it can work at high pwm frequencies
    [H0FR70.brd, H0FR70.xlsx, H0FR71.brd, H0FR71.sch, H0FR71.xlsx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]
2023-11-04 -Update the electronic & layout designs to improve the performance (the BOM have been changed too) .
    [H0FR71.brd, H0FR71.xlsx, H0FR72.brd, H0FR72.sch, H0FR72.xlsx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]
2023-11-04 -Correcting some documentation issues
    [H0FR72.xlsx]
2023-11-05 -Add additional 10u capacitor to gate driver IC supply
    [H0FR72.brd, H0FR72.sch, H0FR72.xlsx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]
2023-11-05 -Fix BOM
    [H0FR72.xlsx]
2024-05-26 Design modification
    [H0FR72.brd, H0FR72.sch]
2024-05-28 Schematic modification
    [H0FR72.brd, H0FR72.sch]
2024-06-01 -Edit the description
    [H0FR72.brd, H0FR72.sch]
2024-06-18 The new Layout design for the new Electronic design has been done. Reveiwed version.
    [H0FR7.brd, H0FR7.sch, H0FR7.xlsx, H0FR72.brd, H0FR72.sch, H0FR72.xlsx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]
2024-07-15 -Activate the thermal option for the polygon
    [H0FR7.brd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]
